LuxInTenebr1s/esp-light-box/esp-led-box.kicad_pcb

## KiCad design esp-led-box.kicad_pcb (2021-07-17)

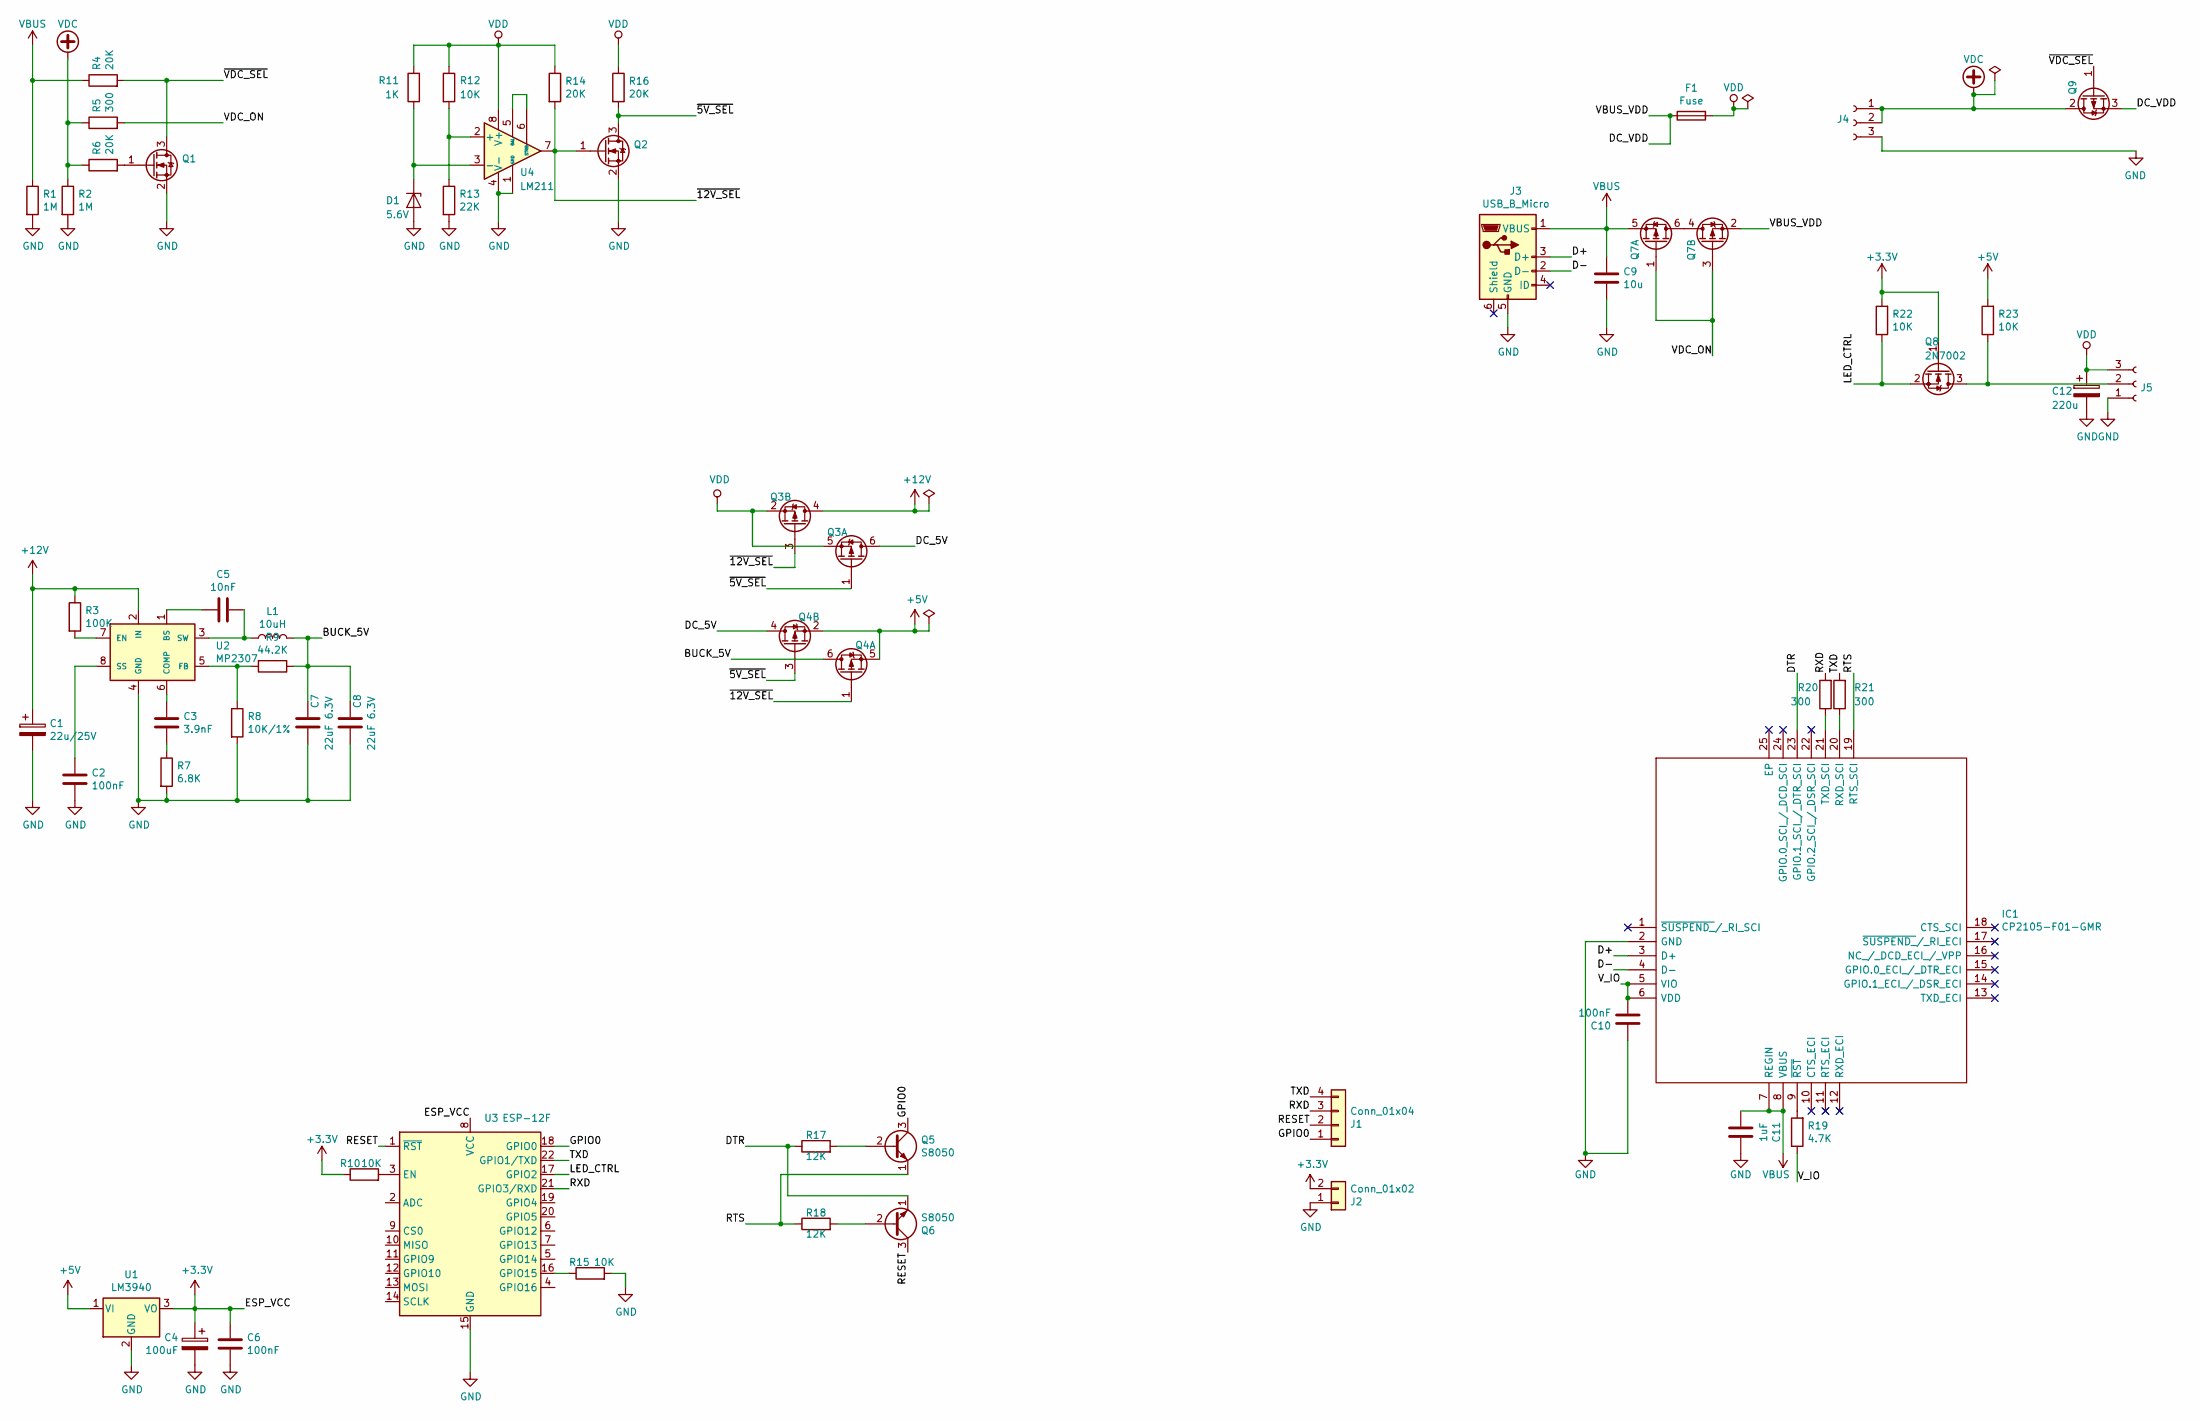
[picture p1: schematic esp-led-box.sch]

Parts:
C1: 22u/25V; C_0805_2012Metric; LCSC C45783
C2, C6, C10: 100nF; C_0402_1005Metric; LCSC C307331
C3: 3.9nF; C_0402_1005Metric; LCSC C18047
C4: 100uF; CP_EIA-3528-21_Kemet-B; LCSC C16133
C5: 10nF; C_0402_1005Metric; LCSC C15195
C7, C8: 22uF 6.3V; C_0603_1608Metric; LCSC C59461
C9: 10u; C_0603_1608Metric; LCSC C19702
C11: 1uF; C_0402_1005Metric
C12: 220u; CP_Elec_6.3x7.7; LCSC C127327
D1: 5.6V; D_MiniMELF; LCSC C8062
F1: Fuse; fuseholder_blade_common_aliexpress
IC1: CP2105-F01-GMR; QFN50P400X400X80-25N-D; Manufacturer_Part_Number CP2105-F01-GMR; Mouser Part Number 634-CP2105-F01-GMR
J1: Conn_01x04; PinHeader_1x04_P2.54mm_Vertical
J2: Conn_01x02; PinHeader_1x02_P2.54mm_Vertical
J3: USB_B_Micro; USB_Micro-B_Molex-105017-0001
J4, J5: Conn_01x03_Female; SolderWire_1x03_2.5x6
L1: 10uH; L_Sunlord_MWSA0518_5.4x5.2mm; LCSC C181721
Q1, Q2, Q8: 2N7002; SOT-23; LCSC C8545
Q3, Q4, Q7: Q_PMOS_DGS; SOT-23-6; LCSC C148368
Q5, Q6: S8050; SOT-23; LCSC C2146
Q9: Q_PMOS_DGS; TO-252-2; LCSC C67281
R1, R2: 1M; R_0402_1005Metric; LCSC C26083
R3: 100K; R_0402_1005Metric; LCSC C25741
R4, R6: 20K; R_0603_1608Metric; LCSC C4184
R5: 300; R_0805_2012Metric; LCSC C17617
R7: 6.8K; R_0402_1005Metric; LCSC C25917
R8: 10K/1%; R_0402_1005Metric; LCSC C25744
R9: 44.2K; R_0402_1005Metric; LCSC C25895
R10, R12, R15, R22, R23: 10K; R_0402_1005Metric; LCSC C25744
R11: 1K; R_0603_1608Metric; LCSC C21190
R13: 22K; R_0402_1005Metric; LCSC C25768
R14, R16: 20K; R_0402_1005Metric; LCSC C25765
R17, R18: 12K; R_0402_1005Metric; LCSC C25752
R19: 4.7K; R_0402_1005Metric; LCSC C25900
R20, R21: 300; R_0402_1005Metric; LCSC C25774
U1: LM3940; SOT-223-3_TabPin2; LCSC C140319
U2: MP2307; SOIC-8_3.9x4.9mm_P1.27mm; LCSC C18921
U3: ESP-12F; ESP-12E
U4: LM211; SOIC-8-1EP_3.9x4.9mm_P1.27mm_EP2.29x3mm; LCSC C99580

Connections:
+3V3: C4.1, C6.1, J2.2, Q8.1 (G), R10.1, R22.2, U1.3 (VO), U3.8 (VCC)
+5V: Q4.2 (S), Q4.5 (S), R23.2, U1.1 (VI)
+12V: C1.1, Q3.4 (D), R3.1, U2.2 (IN)
/BUCK_5V: C7.1, C8.1, L1.2, Q4.6 (D), R9.1
/D+: IC1.3 (D+), J3.3 (D+)
/D-: IC1.4 (D-), J3.2 (D-)
/DC_5V: Q3.6 (D), Q4.4 (D)
/DC_VDD: F1.1, Q7.2 (S), Q9.3 (S)
/DTR: IC1.23 (GPIO.1_SCI_/_DTR_SCI), Q6.1 (E), R17.1
/GPIO0: J1.1, Q5.3 (C), U3.18 (GPIO0)
/LED_CTRL: Q8.2 (S), R22.1, U3.17 (GPIO2)
/RESET: J1.2, Q6.3 (C), U3.1 (~RST)
/RTS: IC1.19 (RTS_SCI), Q5.1 (E), R18.1
/RXD: J1.3, R20.2, U3.21 (GPIO3/RXD)
/TXD: J1.4, R21.2, U3.22 (GPIO1/TXD)
/VDC_ON: Q7.1 (G), Q7.3 (G), R5.2
/V_IO: C10.2, IC1.5 (VIO), IC1.6 (VDD), R19.1
/~5V_SEL: Q2.3 (D), Q3.1 (G), Q4.3 (G), R16.2; also elsewhere on the board
/~12V_SEL: Q2.1 (G), Q3.3 (G), Q4.1 (G), R14.2, U4.7; also elsewhere on the board
/~VDC_SEL: Q1.3 (D), Q9.1 (G), R4.2
GND: C1.2, C2.2, C4.2, C6.2, C7.2, C8.2, C9.1, C10.1, C11.2, C12.2, D1.2 (A), IC1.2 (GND), J2.1, J3.5 (GND), J4.3, J5.1, Q1.2 (S), Q2.2 (S), R1.2, R2.2, R7.2, R8.2, R13.2, R15.2, U1.2 (GND), U2.4 (GND), U3.15 (GND), U4.1 (GND), U4.4 (V-); also elsewhere on the board
unnamed: C2.1, U2.8 (SS)
unnamed: C3.1, U2.6 (COMP)
unnamed: C3.2, R7.1
unnamed: C5.1, L1.1, U2.3 (SW)
unnamed: C5.2, U2.1 (BS)
unnamed: D1.1 (K), R11.1, U4.3 (-)
unnamed: IC1.9 (~RST), R19.2
unnamed: IC1.20 (RXD_SCI), R21.1
unnamed: IC1.21 (TXD_SCI), R20.1
unnamed: J5.2, Q8.3 (D), R23.1
unnamed: Q1.1 (G), R6.2
unnamed: Q5.2 (B), R17.2
unnamed: Q6.2 (B), R18.2
unnamed: Q7.4 (D), Q7.6 (D)
unnamed: R3.2, U2.7 (EN)
unnamed: R8.1, R9.2, U2.5 (FB)
unnamed: R10.2, U3.3 (EN)
unnamed: R12.2, R13.1, U4.2 (+)
unnamed: R15.1, U3.16 (GPIO15)
unnamed: U4.5 (BAL), U4.6 (STRB)
VBUS: C9.2, C11.1, IC1.7 (REGIN), IC1.8 (VBUS), J3.1 (VBUS), Q7.5 (S), R1.1, R4.1
VDC: J4.1, J4.2, Q9.2 (D), R2.1, R5.1, R6.1
VDD: C12.1, F1.2, J5.3, Q3.2 (S), Q3.5 (S), R11.2, R12.1, R14.1, R16.1, U4.8 (V+)

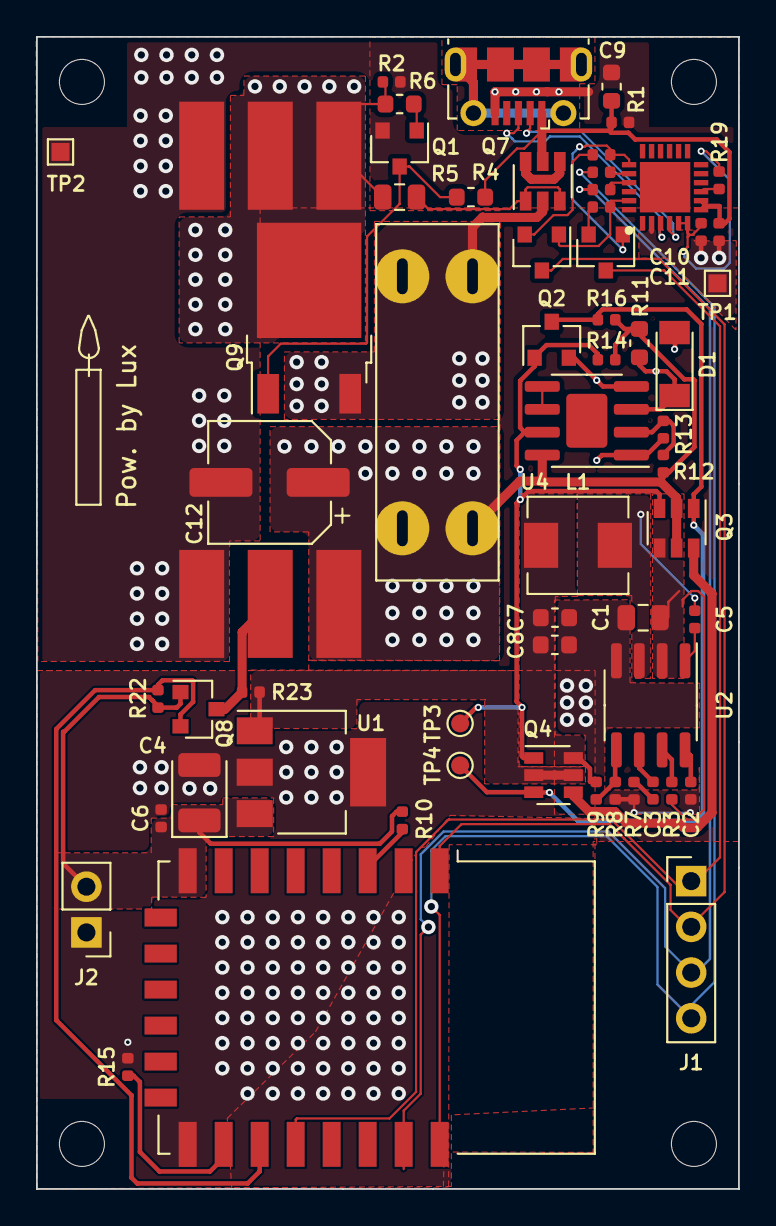
[picture p2: board esp-led-box.kicad_pcb from above]

Board: 2 copper layers, 39.0 x 64.0 mm, 61 parts (0 on the bottom side), 44 nets.

Other parts of the board:
TP1, TP2: GND; TestPoint_Pad_1.0x1.0mm
TP3: ~12V_SEL; TestPoint_Pad_D1.0mm
TP4: ~5V_SEL; TestPoint_Pad_D1.0mm

Their connections:
/~5V_SEL: TP4.1; also elsewhere on the board
/~12V_SEL: TP3.1; also elsewhere on the board
GND: TP1.1, TP2.1; also elsewhere on the board
