LuxInTenebr1s/esp-light-box/(commit log)

2020-03-13 Fixed iteration #2
    - replace 0603 SMDs with 1206 ones;
    - add fuse holder
    - add two ACT LEDs
    - fix level shifter transistor scheme
    - add degson terminal block
    - use 2.56 pin header
    - add GPIO0, +3.3v pins to pin header
    [esp-led-box.kicad_pcb, esp-led-box.sch]
2020-03-19 pcb: make ready for manufacturing
    - dummy resistors to switch from +12v power input to +5v input to make box be usable with different LED strips
    - some cosmetic changes withing .sch
    - put protection diode inline not parallel
    [esp-led-box.kicad_pcb, esp-led-box.sch]
2020-03-19 silkmask: fix designators overlap
    [esp-led-box.kicad_pcb]
2020-03-22 rework fuse holder: use one from aliexpress
    https://aliexpress.ru/item/32838425418.html?spm=a2g0s.9042311.0.0.5f9933edQqCEM1 here is the link (it supposed to be used with micro blades fuses)
    [esp-led-box.kicad_pcb, esp-led-box.sch]
2020-10-11 pcb v0.3 update
    - add possibility to use switch instead of dummy resisters
    - add micro USB footprint for portable use
    - add buttons for RESET and GPIO0 ESP inputs
    - make it fancier with components density increased
    - add case mountpoints
    [esp-led-box.kicad_pcb, esp-led-box.sch]
2021-06-15 pre-version: still needs to fix some problems and breadboard it
    [esp-led-box.sch]
2021-07-16 my new version is coming
    [esp-led-box.kicad_pcb, esp-led-box.sch]
2021-07-16 kek forgot it
    [esp-led-box.sch]
2021-07-16 another kek
    [esp-led-box.kicad_pcb, esp-led-box.sch]
2021-07-16 another kek hehe
    [esp-led-box.kicad_pcb]
2021-07-17 will I ever stop?
    [esp-led-box.sch]
2021-07-17 finally we are done
    [esp-led-box.kicad_pcb, esp-led-box.sch]
2021-07-17 ... dont say anything
    [esp-led-box.kicad_pcb]
